teapotlaboratories/bwlc1a/README.md

# blwc1a
 Low-power Cellular GPS Tracker
