teapotlaboratories/bwlc1a/hardware/stack-up.png

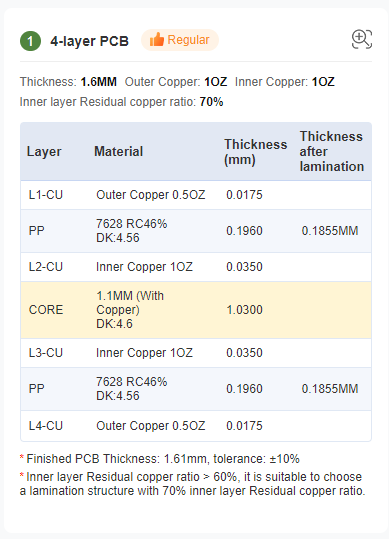
hardware/stack-up.png
