teapotlaboratories/bwlc1a/hardware/kicad/bwlc1a.kicad_pcb

## KiCad design hardware/kicad/bwlc1a.kicad_pcb (2024-05-23)

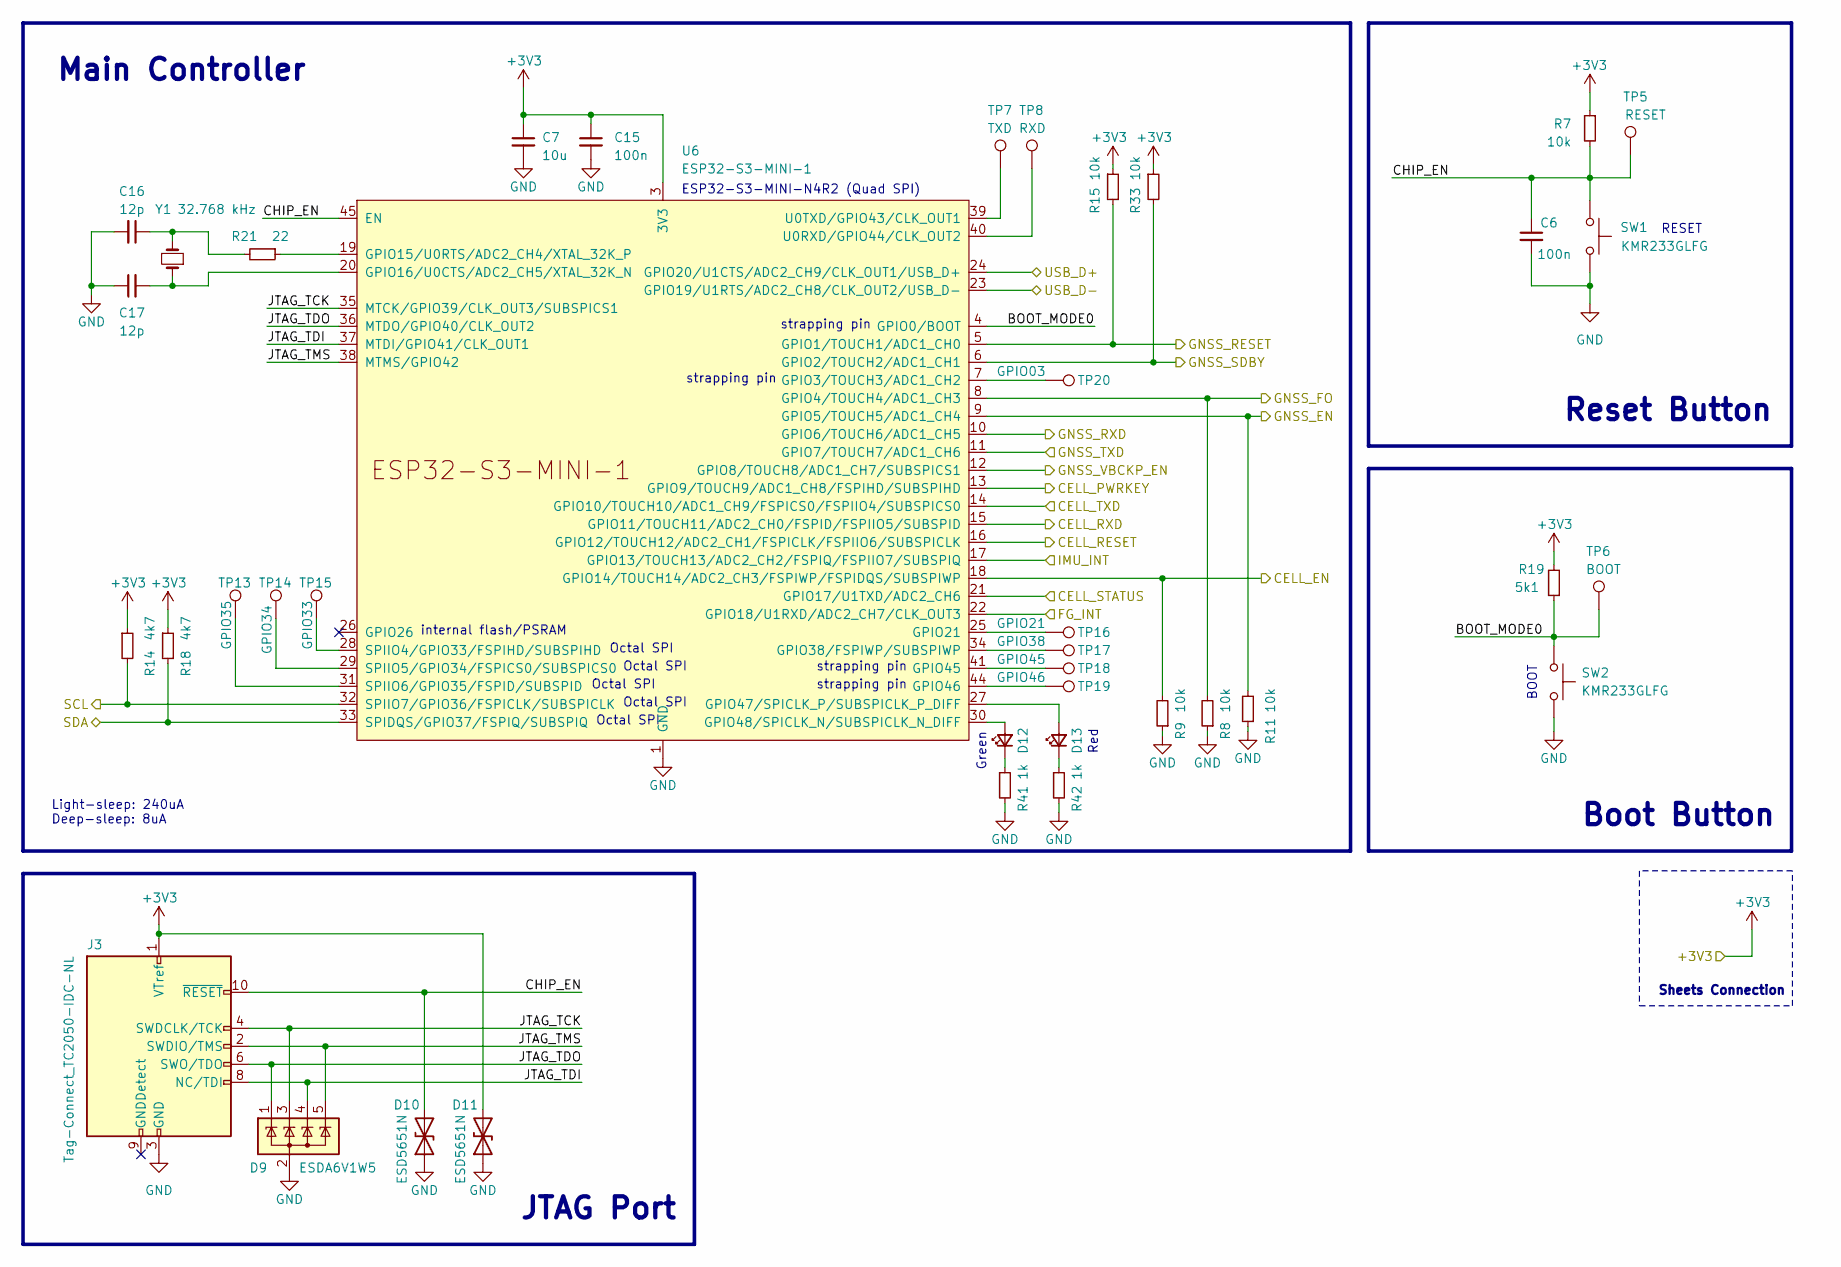
[picture p2: schematic main_controller.kicad_sch, Main Controller]

Parts:
C6, C15: 100n; C_0402_1005Metric; Manufacturer Part Number CL05B104KO5NNNC
C7: 10u; C_0603_1608Metric; Manufacturer Part Number CL10A106KP8NNNC
C16, C17: 12p; C_0402_1005Metric; Manufacturer Part Number 0402CG120J500NT
D9: ESDA6V1W5; SOT-353_SC-70-5; Manufacturer Part Number ESDA6V1W5-TP
D10, D11: ESD5651N; D_SOD-882; Manufacturer Part Number ESD5651N
D12: LTST-C191KGKT; LED_0603_1608Metric; Manufacturer Part Number LTST-C191KGKT
D13: LTST-C191KRKT; LED_0603_1608Metric; Manufacturer Part Number LTST-C191KRKT
J3: Tag-Connect_TC2050-IDC-NL; Tag-Connect_TC2050-IDC-NL_2x05_P1.27mm_Vertical
R7, R8, R9, R11, R15, R33: 10k; R_0402_1005Metric; Manufacturer Part Number 0402WGF1002TCE
R14, R18: 4k7; R_0402_1005Metric; Manufacturer Part Number 0402WGJ0472TCE
R19: 5k1; R_0402_1005Metric; Manufacturer Part Number 0402WGF5101TCE
R21: 22; R_0402_1005Metric; Manufacturer Part Number 0402WGF220JTCE
R41, R42: 1k; R_0402_1005Metric; Manufacturer Part Number 0402WGJ0102TCE
SW1, SW2: KMR233GLFG; SW-SMD_L3.9-W3.0-P4.45; Manufacturer Part Number KMR233GLFG
TP5: RESET; TestPoint_Pad_D1.0mm
TP6: BOOT; TestPoint_Pad_D1.0mm
TP7: TXD; TestPoint_Pad_D1.0mm
TP8: RXD; TestPoint_Pad_D1.0mm
TP13: GPIO35; TestPoint_Pad_D1.0mm
TP14: GPIO34; TestPoint_Pad_D1.0mm
TP15: GPIO33; TestPoint_Pad_D1.0mm
TP16: GPIO21; TestPoint_Pad_D1.0mm
TP17: GPIO38; TestPoint_Pad_D1.0mm
TP18: GPIO45; TestPoint_Pad_D1.0mm
TP19: GPIO46; TestPoint_Pad_D1.0mm
TP20: GPIO03; TestPoint_Pad_D1.0mm
U6: ESP32-S3-MINI-1; Manufacturer Part Number ESP32-S3-MINI-1-N4R2
Y1: 32.768 kHz; Crystal_SMD_3215-2Pin_3.2x1.5mm; Manufacturer Part Number Q13FC1350000400

Connections:
+3V3: C7.1, C15.1, D11.2 (A2), J3.1 (VTref), R7.1, R14.1, R15.1, R18.1, R19.2, R33.1, U6.3 (3V3); also elsewhere on the board
/Cellular/CELL_PWRKEY: U6.13 (GPIO9/TOUCH9/ADC1_CH8/FSPIHD/SUBSPIHD); also elsewhere on the board
/Cellular/CELL_RESET: U6.16 (GPIO12/TOUCH12/ADC2_CH1/FSPICLK/FSPIIO6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); also elsewhere on the board
/Cellular/CELL_RXD: U6.15 (GPIO11/TOUCH11/ADC2_CH0/FSPID/FSPIIO5/S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); also elsewhere on the board
/Cellular/CELL_STATUS: U6.21 (GPIO17/U1TXD/ADC2_CH6); also elsewhere on the board
/Cellular/CELL_TXD: U6.14 (GPIO10/TOUCH10/ADC1_CH9/FSPICS0/FSPIIO4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); also elsewhere on the board
/GNSS/GNSS_FO: R8.2, U6.8 (GPIO4/TOUCH4/ADC1_CH3); also elsewhere on the board
/GNSS/GNSS_RESET: R15.2, U6.5 (GPIO1/TOUCH1/ADC1_CH0); also elsewhere on the board
/GNSS/GNSS_RXD: U6.10 (GPIO6/TOUCH6/ADC1_CH5); also elsewhere on the board
/GNSS/GNSS_SDBY: R33.2, U6.6 (GPIO2/TOUCH2/ADC1_CH1); also elsewhere on the board
/GNSS/GNSS_TXD: U6.11 (GPIO7/TOUCH7/ADC1_CH6); also elsewhere on the board
/Main Controller/BOOT_MODE0: R19.1, SW2.1, TP6.1, U6.4 (GPIO0/BOOT)
/Main Controller/CELL_EN: R9.2, U6.18 (GPIO14/TOUCH14/ADC2_CH3/FSPIWP/FSPIDQS/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); also elsewhere on the board
/Main Controller/CHIP_EN: C6.1, D10.2 (A2), J3.10 (~RESET), R7.2, SW1.2, TP5.1, U6.45 (EN)
/Main Controller/FG_INT: U6.22 (GPIO18/U1RXD/ADC2_CH7/CLK_OUT3); also elsewhere on the board
/Main Controller/GNSS_EN: R11.2, U6.9 (GPIO5/TOUCH5/ADC1_CH4); also elsewhere on the board
/Main Controller/GNSS_VBCKP_EN: U6.12 (GPIO8/TOUCH8/ADC1_CH7/SUBSPICS1); also elsewhere on the board
/Main Controller/IMU_INT: U6.17 (GPIO13/TOUCH13/ADC2_CH2/FSPIQ/FSPIIO7/S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); also elsewhere on the board
/Main Controller/JTAG_TCK: D9.3 (K), J3.4 (SWDCLK/TCK), U6.35 (MTCK/GPIO39/CLK_OUT3/SUBSPICS1)
/Main Controller/JTAG_TDI: D9.4 (K), J3.8 (NC/TDI), U6.37 (MTDI/GPIO41/CLK_OUT1)
/Main Controller/JTAG_TDO: D9.1 (K), J3.6 (SWO/TDO), U6.36 (MTDO/GPIO40/CLK_OUT2)
/Main Controller/JTAG_TMS: D9.5 (K), J3.2 (SWDIO/TMS), U6.38 (MTMS/GPIO42)
/Main Controller/SCL: R14.2, U6.32 (SPIIO7/GPIO36/FSPICLK/SUBSPICLK); also elsewhere on the board
/Main Controller/SDA: R18.2, U6.33 (SPIDQS/GPIO37/FSPIQ/SUBSPIQ); also elsewhere on the board
/Main Controller/USB_D+: U6.24 (GPIO20/U1CTS/ADC2_CH9/CLK_OUT1/USB_D+); also elsewhere on the board
/Main Controller/USB_D-: U6.23 (GPIO19/U1RTS/ADC2_CH8/CLK_OUT2/USB_D-); also elsewhere on the board
GND: C6.2, C7.2, C15.2, C16.2, C17.1, D9.2 (A), D10.1 (A1), D11.1 (A1), J3.3 (GND), J3.5 (GND), R8.1, R9.1, R11.1, R41.2, R42.2, SW1.1, SW2.2, U6.1 (GND), U6.2 (GND), U6.42 (GND), U6.43 (GND), U6.46 (GND), U6.47 (GND), U6.48 (GND), U6.49 (GND), U6.50 (GND), U6.51 (GND), U6.52 (GND), U6.53 (GND), U6.54 (GND), U6.55 (GND), U6.56 (GND), U6.57 (GND), U6.58 (GND), U6.59 (GND), U6.60 (GND), U6.61 (GND), U6.62 (GND), U6.63 (GND), U6.64 (GND), U6.65 (GND); also elsewhere on the board
unnamed: C16.1, R21.2, Y1.2
unnamed: D12.2 (A), U6.30 (GPIO48/SPICLK_N/SUBSPICLK_N_DIFF)
unnamed: D12.1 (K), R41.1
unnamed: D13.2 (A), U6.27 (GPIO47/SPICLK_P/SUBSPICLK_P_DIFF)
unnamed: D13.1 (K), R42.1
unnamed: TP20.1, U6.7 (GPIO3/TOUCH3/ADC1_CH2)
unnamed: R21.1, U6.19 (GPIO15/U0RTS/ADC2_CH4/XTAL_32K_P)
unnamed: C17.2, U6.20 (GPIO16/U0CTS/ADC2_CH5/XTAL_32K_N), Y1.1
unnamed: TP16.1, U6.25 (GPIO21)
unnamed: TP17.1, U6.34 (GPIO38/FSPIWP/SUBSPIWP)
unnamed: TP18.1, U6.41 (GPIO45)
unnamed: TP19.1, U6.44 (GPIO46)
unnamed: TP15.1, U6.28 (SPIIO4/GPIO33/FSPIHD/SUBSPIHD)
unnamed: TP14.1, U6.29 (SPIIO5/GPIO34/FSPICS0/SUBSPICS0)
unnamed: TP13.1, U6.31 (SPIIO6/GPIO35/FSPID/SUBSPID)
unnamed: TP8.1, U6.40 (U0RXD/GPIO44/CLK_OUT2)
unnamed: TP7.1, U6.39 (U0TXD/GPIO43/CLK_OUT1)

Notes on the sheet:
ESP32-S3-MINI-N4R2 (Quad SPI)
Red
Reset Button
strapping pin
Octal SPI
Main Controller
JTAG Port
Green
Boot Button
RESET
Sheets Connection
internal flash/PSRAM
BOOT
Light-sleep: 240uA Deep-sleep: 8uA

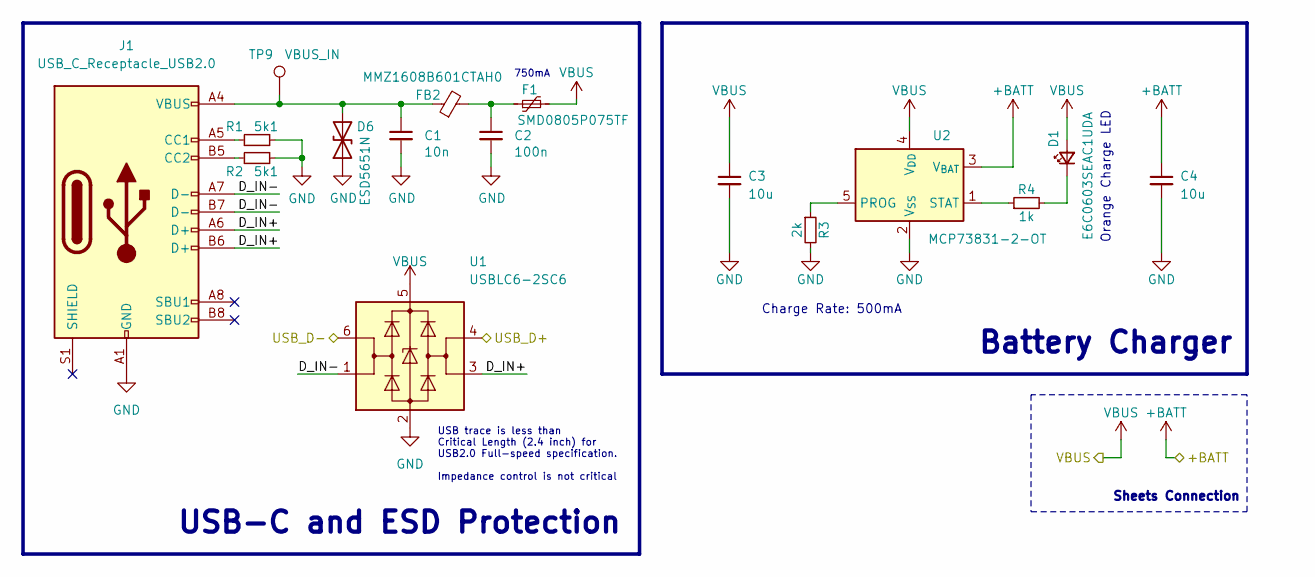
[picture p3: schematic usb_and_charger.kicad_sch, USB and Charger]

Parts:
C1: 10n; C_0402_1005Metric; Manufacturer Part Number CC0402KRX7R9BB103
C2: 100n; C_0402_1005Metric; Manufacturer Part Number CL05B104KO5NNNC
C3, C4: 10u; C_0603_1608Metric; Manufacturer Part Number CL10A106KP8NNNC
D1: E6C0603SEAC1UDA; LED_0603_1608Metric; Manufacturer Part Number E6C0603SEAC1UDA
D6: ESD5651N; D_SOD-882; Manufacturer Part Number ESD5651N
F1: SMD0805P075TF; Fuse_0805_2012Metric; Manufacturer Part Number SMD0805P075TF
FB2: MMZ1608B601CTAH0; L_0603_1608Metric; Manufacturer Part Number MMZ1608B601CTAH0
J1: USB_C_Receptacle_USB2.0; USB_C_Receptacle_HRO_TYPE-C-31-M-12; Manufacturer Part Number TYPE-C-31-M-12
R1, R2: 5k1; R_0402_1005Metric; Manufacturer Part Number 0402WGF5101TCE
R3: 2k; R_0402_1005Metric; Manufacturer Part Number RC0402FR-072KL
R4: 1k; R_0402_1005Metric; Manufacturer Part Number 0402WGJ0102TCE
TP9: VBUS_IN; TestPoint_Pad_D1.0mm
U1: USBLC6-2SC6; SOT-23-6; Manufacturer Part Number USBLC6-2SC6
U2: MCP73831-2-OT; SOT-23-5; Manufacturer Part Number MCP73831T-2ATI/OT

Connections:
+BATT: C4.1, U2.3 (V_{BAT}); also elsewhere on the board
/Main Controller/USB_D+: U1.4 (I/O2); also elsewhere on the board
/Main Controller/USB_D-: U1.6 (I/O1); also elsewhere on the board
/USB and Charger/D_IN+: J1.A6 (D+), J1.B6 (D+), U1.3 (I/O2)
/USB and Charger/D_IN-: J1.A7 (D-), J1.B7 (D-), U1.1 (I/O1)
GND: C1.2, C2.2, C3.2, C4.2, D6.1 (A1), J1.A1 (GND), J1.A12 (GND), J1.B1 (GND), J1.B12 (GND), R1.2, R2.2, R3.2, U1.2 (GND), U2.2 (V_{SS}); also elsewhere on the board
unnamed: C2.1, F1.1, FB2.2
unnamed: D1.1 (K), R4.2
unnamed: C1.1, D6.2 (A2), FB2.1, J1.A4 (VBUS), J1.A9 (VBUS), J1.B4 (VBUS), J1.B9 (VBUS), TP9.1
unnamed: J1.A5 (CC1), R1.1
unnamed: J1.B5 (CC2), R2.1
unnamed: R3.1, U2.5 (PROG)
unnamed: R4.1, U2.1 (STAT)
VBUS: C3.1, D1.2 (A), F1.2, U1.5 (VBUS), U2.4 (V_{DD})

Notes on the sheet:
Orange Charge LED
Battery Charger
USB trace is less than Critical Length (2.4 inch) for USB2.0 Full-speed specification. Impedance control is not critical
Sheets Connection
750mA
Charge Rate: 500mA
USB-C and ESD Protection

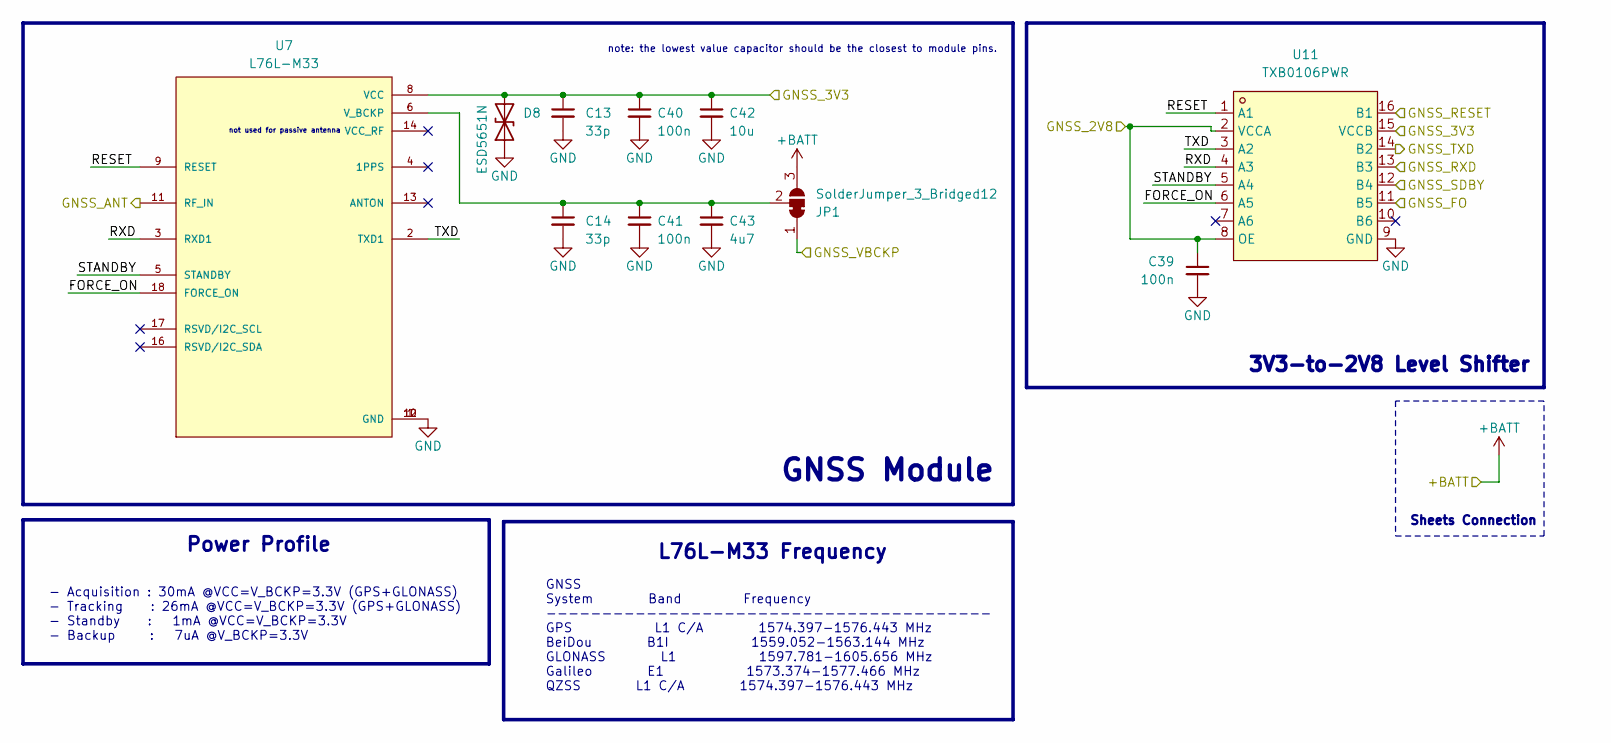
[picture p4: schematic gnss.kicad_sch]

Parts:
C13, C14: 33p; C_0603_1608Metric; Manufacturer Part Number CC0603JRNPO9BN330
C39, C40, C41: 100n; C_0603_1608Metric; Manufacturer Part Number CL10B104KO8NNNC
C42: 10u; C_0603_1608Metric; Manufacturer Part Number CL10A106KP8NNNC
C43: 4u7; C_0603_1608Metric; Manufacturer Part Number CL10A475KP8NNNC
D8: ESD5651N; D_SOD-882; Manufacturer Part Number ESD5651N
JP1: SolderJumper_3_Bridged12; SolderJumper-3_P1.3mm_Bridged2Bar12_RoundedPad1.0x1.5mm
U7: L76L-M33; Manufacturer Part Number L76L-M33
U11: TXB0106PWR; TSSOP-16_L5.0-W4.4-P0.65-LS6.4-BL; Manufacturer Part Number TXB0106PWR

Connections:
+BATT: JP1.3 (B); also elsewhere on the board
/Antenna/GNSS_ANT: U7.11 (RF_IN); also elsewhere on the board
/GNSS/FORCE_ON: U7.18 (FORCE_ON), U11.6 (A5)
/GNSS/GNSS_FO: U11.11 (B5); also elsewhere on the board
/GNSS/GNSS_RESET: U11.16 (B1); also elsewhere on the board
/GNSS/GNSS_RXD: U11.13 (B3); also elsewhere on the board
/GNSS/GNSS_SDBY: U11.12 (B4); also elsewhere on the board
/GNSS/GNSS_TXD: U11.14 (B2); also elsewhere on the board
/GNSS/RESET: U7.9 (RESET), U11.1 (A1)
/GNSS/RXD: U7.3 (RXD1), U11.4 (A3)
/GNSS/STANDBY: U7.5 (STANDBY), U11.5 (A4)
/GNSS/TXD: U7.2 (TXD1), U11.3 (A2)
/GNSS_2V8: C39.1, U11.2 (VCCA), U11.8 (OE); also elsewhere on the board
/GNSS_3V3: C13.1, C40.1, C42.1, D8.2 (A2), U7.8 (VCC), U11.15 (VCCB); also elsewhere on the board
/GNSS_VBCKP: JP1.1 (A); also elsewhere on the board
GND: C13.2, C14.2, C39.2, C40.2, C41.2, C42.2, C43.2, D8.1 (A1), U7.1 (GND), U7.10 (GND), U7.12 (GND), U11.9 (GND); also elsewhere on the board
unnamed: C14.1, C41.1, C43.1, JP1.2 (C), U7.6 (V_BCKP)

Notes on the sheet:
GNSS Module
- Acquisition : 30mA @VCC=V_BCKP=3.3V (GPS+GLONASS) - Tracking : 26mA @VCC=V_BCKP=3.3V (GPS+GLONASS) - Standby : 1mA @VCC=V_BCKP=3.3V - Backup : 7uA @V_BCKP=3.3V
3V3-to-2V8 Level Shifter
not used for passive antenna
Sheets Connection
L76L-M33 Frequency
note: the lowest value capacitor should be the closest to module pins.
GNSS System Band Frequency ---------------------------------------- GPS L1 C/A 1574.397-1576.443 MHz BeiDou B1I 1559.052-1563.144 MHz GLONASS L1 1597.781-1605.656 MHz Galileo E1 1573.374-1577.466 MHz QZSS L1 C/A 1574.397-1576.443 MHz
Power Profile

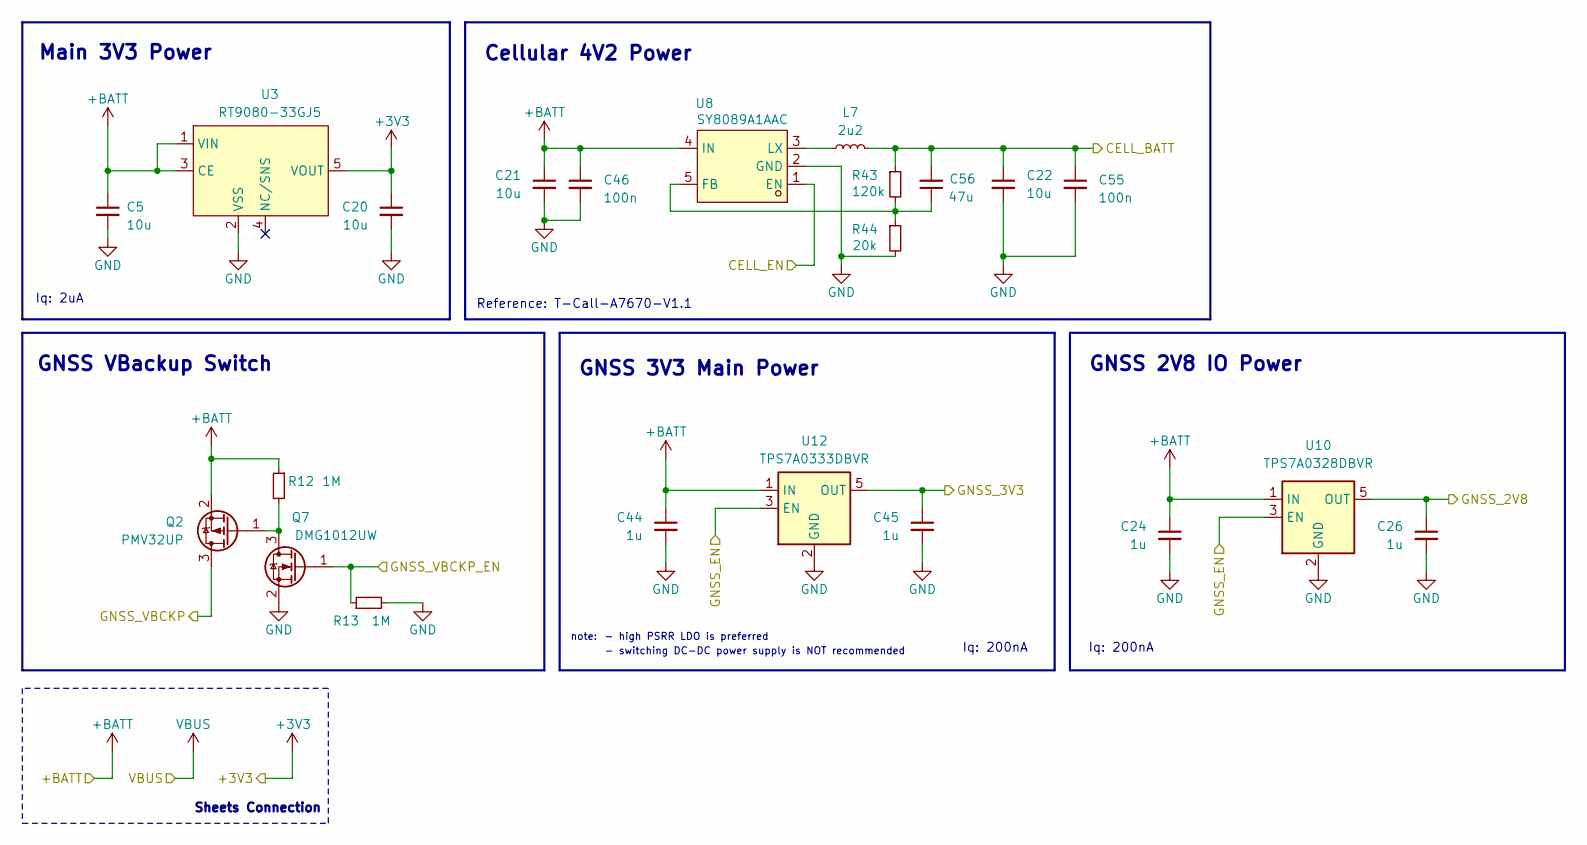
[picture p5: schematic power.kicad_sch]

Parts:
C5, C20, C21, C22: 10u; C_0603_1608Metric; Manufacturer Part Number CL10A106KP8NNNC
C24, C26, C44, C45: 1u; C_0603_1608Metric; Manufacturer Part Number CL10B105KO8NNNC
C46, C55: 100n; C_0603_1608Metric; Manufacturer Part Number CL10B104KO8NNNC
C56: 47u; C_0603_1608Metric; Manufacturer Part Number GRM188R60J476ME15D
L7: 2u2; IND-SMD_L3.0-W3.0_LVS303015H-2R2M-N; Manufacturer Part Number LVS303015-2R2M-N
Q2: PMV32UP; SOT-23; Manufacturer Part Number PMV32UP
Q7: DMG1012UW; SOT-323_SC-70; Manufacturer Part Number DMG1012UW-7
R12, R13: 1M; R_0603_1608Metric; Manufacturer Part Number 0603WAF1004T5E
R43: 120k; R_0603_1608Metric; Manufacturer Part Number 0603WAF1203T5E
R44: 20k; R_0603_1608Metric; Manufacturer Part Number 0603WAF2002T5E
U3: RT9080-33GJ5; SOT-23-5; Manufacturer Part Number RT9080-33GJ5
U8: SY8089A1AAC; SOT-23-5; Manufacturer Part Number SY8089A1AAC
U10: TPS7A0328DBVR; SOT-23-5; Manufacturer Part Number TPS7A0328DBVR
U12: TPS7A0333DBVR; SOT-23-5; Manufacturer Part Number TPS7A0333DBVR

Connections:
+3V3: C20.1, U3.5 (VOUT); also elsewhere on the board
+BATT: C5.1, C21.1, C24.1, C44.1, C46.1, Q2.2 (S), R12.1, U3.1 (VIN), U3.3 (CE), U8.4 (IN), U10.1 (IN), U12.1 (IN); also elsewhere on the board
/Cellular/CELL_BATT: C22.1, C55.1, C56.2, L7.2, R43.1; also elsewhere on the board
/GNSS_2V8: C26.1, U10.5 (OUT); also elsewhere on the board
/GNSS_3V3: C45.1, U12.5 (OUT); also elsewhere on the board
/GNSS_VBCKP: Q2.3 (D); also elsewhere on the board
/Main Controller/CELL_EN: U8.1 (EN); also elsewhere on the board
/Main Controller/GNSS_EN: U10.3 (EN), U12.3 (EN); also elsewhere on the board
/Main Controller/GNSS_VBCKP_EN: Q7.1 (G), R13.1; also elsewhere on the board
GND: C5.2, C20.2, C21.2, C22.2, C24.2, C26.2, C44.2, C45.2, C46.2, C55.2, Q7.2 (S), R13.2, R44.2, U3.2 (VSS), U8.2 (GND), U10.2 (GND), U12.2 (GND); also elsewhere on the board
unnamed: Q2.1 (G), Q7.3 (D), R12.2
unnamed: C56.1, R43.2, R44.1, U8.5 (FB)
unnamed: L7.1, U8.3 (LX)

Notes on the sheet:
Cellular 4V2 Power
- switching DC-DC power supply is NOT recommended
- high PSRR LDO is preferred
GNSS VBackup Switch
Reference: T-Call-A7670-V1.1
GNSS 3V3 Main Power
Iq: 2uA
Main 3V3 Power
Sheets Connection
GNSS 2V8 IO Power
note:
Iq: 200nA

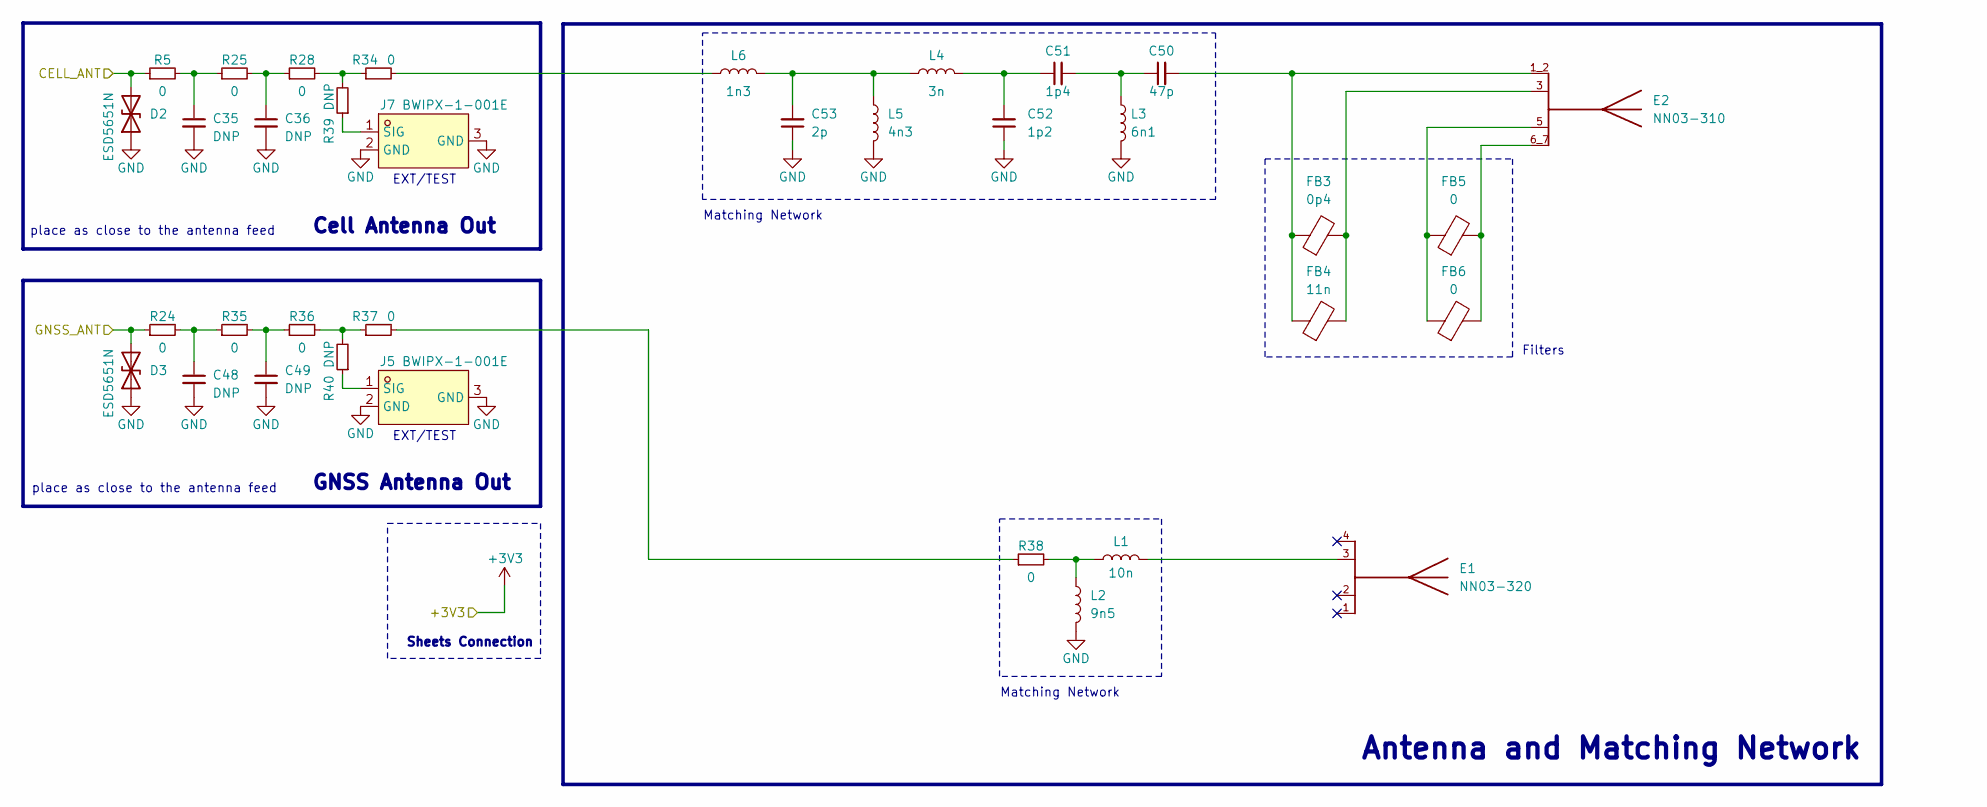
[picture p6: schematic antenna.kicad_sch]

Parts:
C35, C36, C48, C49: DNP; C_0402_1005Metric
C50: 47p; C_0402_1005Metric; Manufacturer Part Number GJM1555C1H470FB01D
C51: 1p4; C_0402_1005Metric; Manufacturer Part Number GJM1555C1H1R4WB01D
C52: 1p2; C_0402_1005Metric; Manufacturer Part Number GJM1555C1H1R2WB01D
C53: 2p; C_0402_1005Metric; Manufacturer Part Number GJM1555C1H2R0WB01D
D2, D3: ESD5651N; D_SOD-882; Manufacturer Part Number ESD5651N
E1: NN03-320; Manufacturer Part Number NN03-320
E2: NN03-310; Manufacturer Part Number NN03-310
FB3: 0p4; L_0402_1005Metric; Manufacturer Part Number GJM1555C1HR40WB01D
FB4: 11n; L_0603_1608Metric; Manufacturer Part Number LQW18AN11NG80D
FB5: 0; L_0402_1005Metric; Manufacturer Part Number 0402WGJ0000TCE
FB6: 0; L_0603_1608Metric; Manufacturer Part Number 0603WAF0000T5E
J5, J7: BWIPX-1-001E; Manufacturer Part Number BWIPX-1-001E
L1: 10n; L_0603_1608Metric; Manufacturer Part Number LQW18AN10NG80
L2: 9n5; L_0603_1608Metric; Manufacturer Part Number LQW18AN9N5G80D
L3: 6n1; L_0402_1005Metric; Manufacturer Part Number LQW15AN6N1B80D
L4: 3n; L_0402_1005Metric; Manufacturer Part Number LQW15AN3N0G80D
L5: 4n3; L_0603_1608Metric; Manufacturer Part Number LQW18AN4N3G80D
L6: 1n3; L_0402_1005Metric; Manufacturer Part Number LQW15AN1N3C80D
R5, R24, R25, R28, R34, R35, R36, R37: 0; R_0402_1005Metric; Manufacturer Part Number 0402WGJ0000TCE
R38: 0; R_0603_1608Metric; Manufacturer Part Number 0603WAF0000T5E
R39, R40: DNP; R_0402_1005Metric

Connections:
/Antenna/CELL_ANT: D2.2 (A2), R5.1; also elsewhere on the board
/Antenna/GNSS_ANT: D3.2 (A2), R24.1; also elsewhere on the board
GND: C35.2, C36.2, C48.2, C49.2, C52.1, C53.1, D2.1 (A1), D3.1 (A1), J5.2 (GND), J5.3 (GND), J7.2 (GND), J7.3 (GND), L2.2, L3.2, L5.2; also elsewhere on the board
unnamed: C35.1, R5.2, R25.1
unnamed: C36.1, R25.2, R28.1
unnamed: C48.1, R24.2, R35.1
unnamed: C49.1, R35.2, R36.1
unnamed: C50.1, C51.2, L3.1
unnamed: C50.2, E2.1_2, FB3.1, FB4.1
unnamed: C51.1, C52.2, L4.2
unnamed: C53.2, L4.1, L5.1, L6.2
unnamed: E1.3, L1.2
unnamed: E2.3, FB3.2, FB4.2
unnamed: E2.5, FB5.1, FB6.1
unnamed: E2.6_7, FB5.2, FB6.2
unnamed: J5.1 (SIG), R40.1
unnamed: J7.1 (SIG), R39.1
unnamed: L1.1, L2.1, R38.2
unnamed: L6.1, R34.2
unnamed: R28.2, R34.1, R39.2
unnamed: R36.2, R37.1, R40.2
unnamed: R37.2, R38.1

Notes on the sheet:
Cell Antenna Out
Filters
EXT/TEST
Sheets Connection
Antenna and Matching Network
place as close to the antenna feed
GNSS Antenna Out
Matching Network

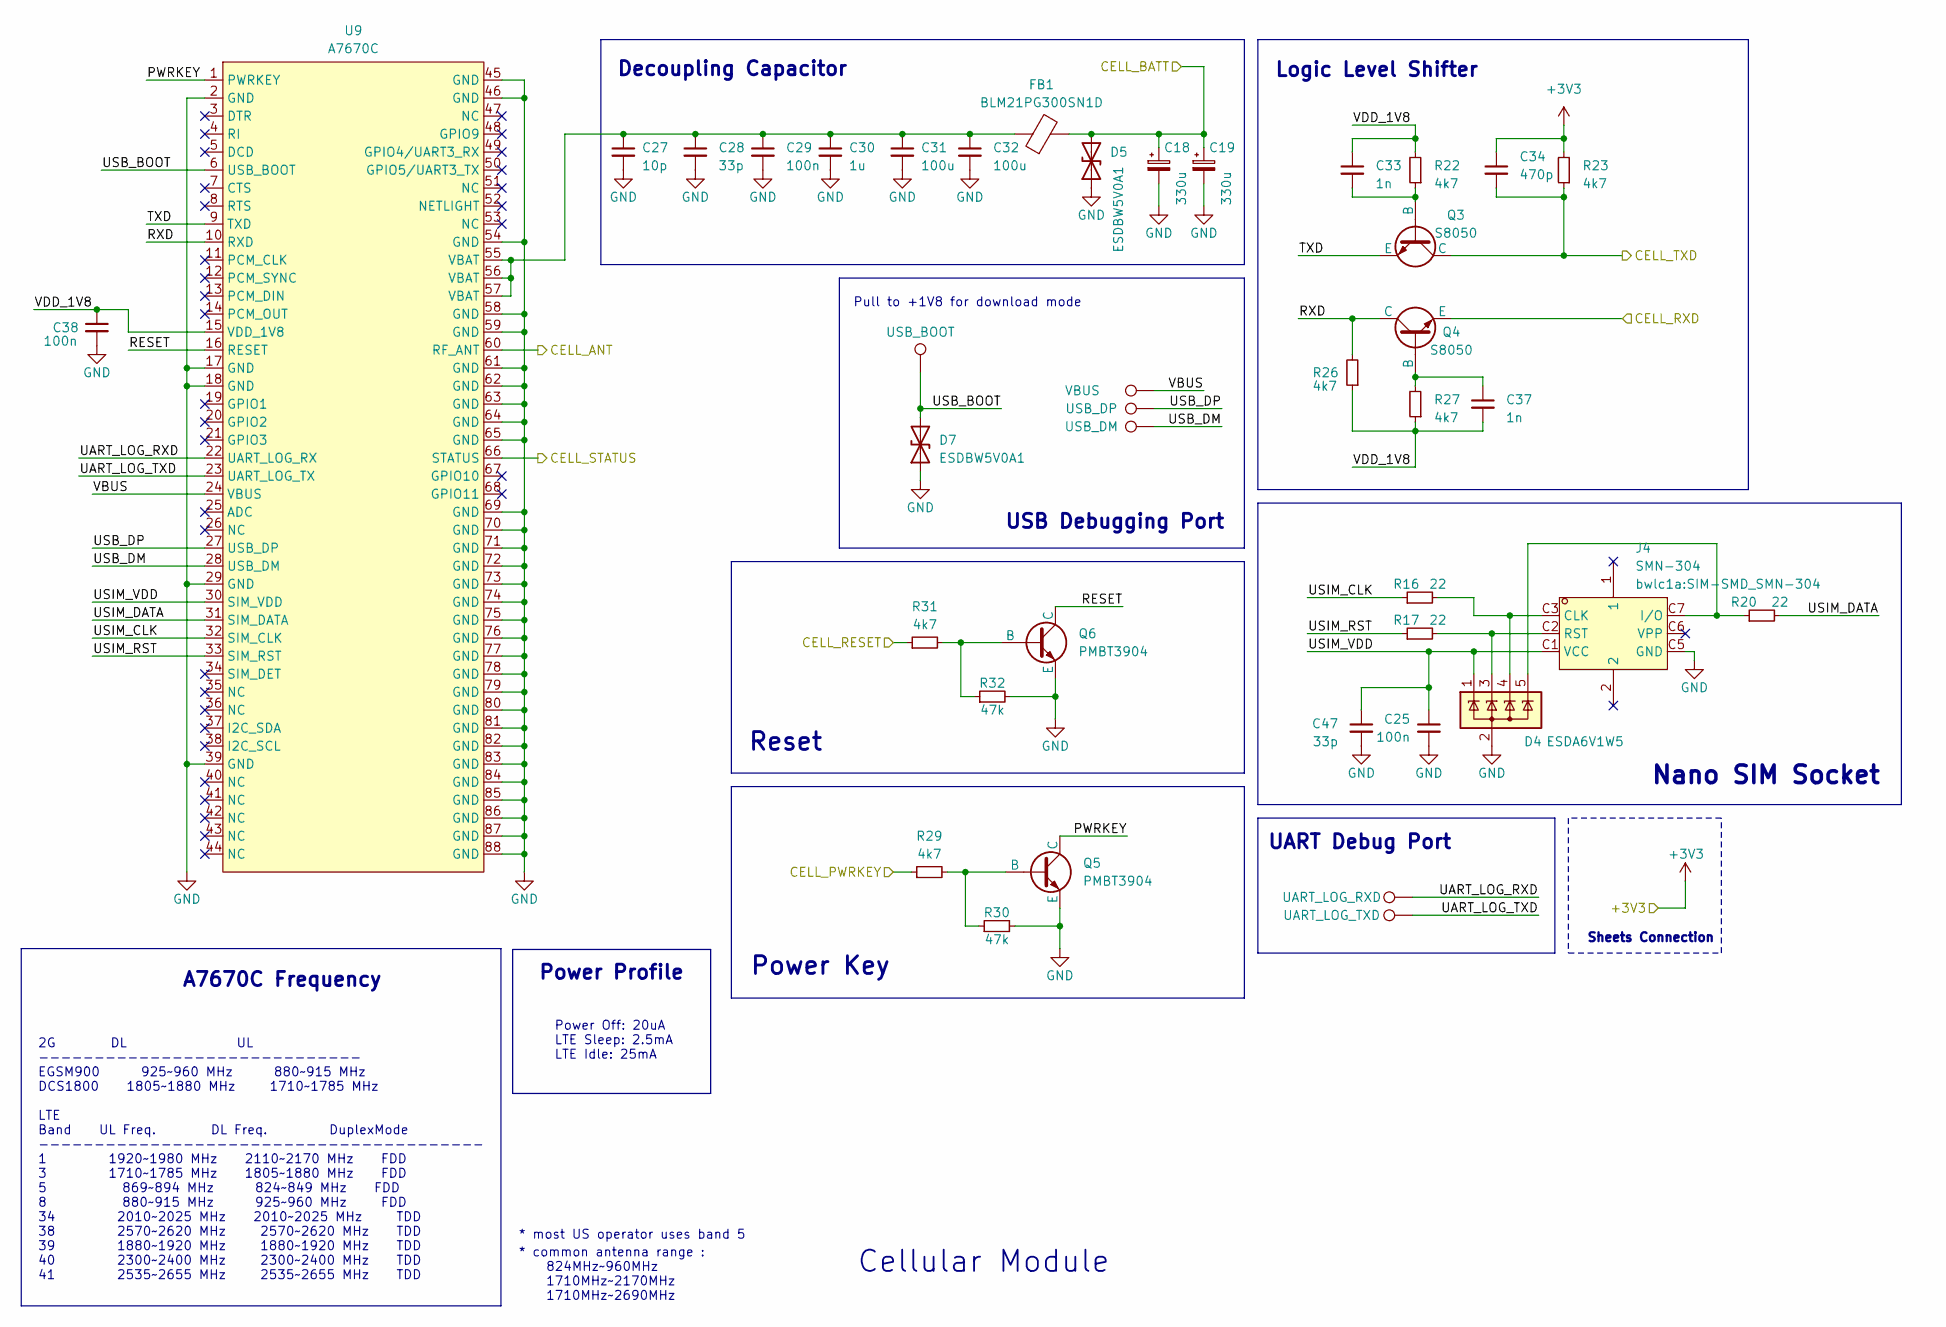
[picture p7: schematic cellular.kicad_sch]

Parts:
C18, C19: 330u; CP_EIA-3528-21_Kemet-B; Manufacturer Part Number T520B337M006ATE040
C25, C29, C38: 100n; C_0402_1005Metric; Manufacturer Part Number CL05B104KO5NNNC
C27: 10p; C_0402_1005Metric; Manufacturer Part Number CC0402JRNPO9BN100
C28, C47: 33p; C_0402_1005Metric; Manufacturer Part Number 0402CG330J500NT
C30: 1u; C_0402_1005Metric; Manufacturer Part Number CL05A105KP5NNNC
C31, C32: 100u; C_0805_2012Metric; Manufacturer Part Number GRM21BR60J107ME15L
C33, C37: 1n; C_0402_1005Metric; Manufacturer Part Number CL05B102KB5NNNC
C34: 470p; C_0402_1005Metric; Manufacturer Part Number CC0402KRX7R9BB471
D4: ESDA6V1W5; SOT-353_SC-70-5; Manufacturer Part Number ESDA6V1W5-TP
D5, D7: ESDBW5V0A1; D_SOD-882; Manufacturer Part Number ESDBW5V0A1
FB1: BLM21PG300SN1D; L_0805_2012Metric; Manufacturer Part Number BLM21PG300SN1D
J4: SMN-304; SIM-SMD_SMN-304; Manufacturer Part Number SMN-304
Q3, Q4: S8050; SOT-23; Manufacturer Part Number S8050
Q5, Q6: PMBT3904; SOT-23; Manufacturer Part Number S8050
R16, R17, R20: 22; R_0402_1005Metric; Manufacturer Part Number 0402WGF220JTCE
R22, R23, R26, R27, R29, R31: 4k7; R_0402_1005Metric; Manufacturer Part Number 0402WGJ0472TCE
R30, R32: 47k; R_0402_1005Metric; Manufacturer Part Number 0402WGF4702TCE
TP1: USB_DP; TestPoint_Pad_D1.0mm
TP2: USB_DM; TestPoint_Pad_D1.0mm
TP3: VBUS; TestPoint_Pad_D1.0mm
TP4: UART_LOG_RXD; TestPoint_Pad_D1.0mm
TP11: USB_BOOT; TestPoint_Pad_D1.0mm
TP12: UART_LOG_TXD; TestPoint_Pad_D1.0mm
U9: A7670C; LGA-124_L24.0-W24.0-P1.0-A7670C-LASS; Manufacturer Part Number A7670C-MASL

Connections:
+3V3: C34.1, R23.2; also elsewhere on the board
/Antenna/CELL_ANT: U9.60 (RF_ANT); also elsewhere on the board
/Cellular/CELL_BATT: C18.1, C19.1, D5.2 (A2), FB1.2; also elsewhere on the board
/Cellular/CELL_PWRKEY: R29.1; also elsewhere on the board
/Cellular/CELL_RESET: R31.1; also elsewhere on the board
/Cellular/CELL_RXD: Q4.3 (E); also elsewhere on the board
/Cellular/CELL_STATUS: U9.66 (STATUS); also elsewhere on the board
/Cellular/CELL_TXD: C34.2, Q3.1 (C), R23.1; also elsewhere on the board
/Cellular/PWRKEY: Q5.1 (C), U9.1 (PWRKEY)
/Cellular/RESET: Q6.1 (C), U9.16 (RESET)
/Cellular/RXD: Q4.1 (C), R26.2, U9.10 (RXD)
/Cellular/TXD: Q3.3 (E), U9.9 (TXD)
/Cellular/UART_LOG_RXD: TP4.1, U9.22 (UART_LOG_RX)
/Cellular/UART_LOG_TXD: TP12.1, U9.23 (UART_LOG_TX)
/Cellular/USB_BOOT: D7.2 (A2), TP11.1, U9.6 (USB_BOOT)
/Cellular/USB_DM: TP2.1, U9.28 (USB_DM)
/Cellular/USB_DP: TP1.1, U9.27 (USB_DP)
/Cellular/USIM_CLK: R16.1, U9.32 (SIM_CLK)
/Cellular/USIM_DATA: R20.2, U9.31 (SIM_DATA)
/Cellular/USIM_RST: R17.1, U9.33 (SIM_RST)
/Cellular/USIM_VDD: C25.1, C47.1, D4.1 (K), J4.C1 (VCC), U9.30 (SIM_VDD)
/Cellular/VBUS: TP3.1, U9.24 (VBUS)
/Cellular/VDD_1V8: C33.1, C37.2, C38.1, R22.2, R26.1, R27.1, U9.15 (VDD_1V8)
GND: C18.2, C19.2, C25.2, C27.2, C28.2, C29.2, C30.2, C31.2, C32.2, C38.2, C47.2, D4.2 (A), D5.1 (A1), D7.1 (A1), J4.C5 (GND), Q5.3 (E), Q6.3 (E), R30.2, R32.2, U9.2 (GND), U9.17 (GND), U9.18 (GND), U9.29 (GND), U9.39 (GND), U9.45 (GND), U9.46 (GND), U9.54 (GND), U9.58 (GND), U9.59 (GND), U9.61 (GND), U9.62 (GND), U9.63 (GND), U9.64 (GND), U9.65 (GND), U9.69 (GND), U9.70 (GND), U9.71 (GND), U9.72 (GND), U9.73 (GND), U9.74 (GND), U9.75 (GND), U9.76 (GND), U9.77 (GND), U9.78 (GND), U9.79 (GND), U9.80 (GND), U9.81 (GND), U9.82 (GND), U9.83 (GND), U9.84 (GND), U9.85 (GND), U9.86 (GND), U9.87 (GND), U9.88 (GND); also elsewhere on the board
unnamed: C27.1, C28.1, C29.1, C30.1, C31.1, C32.1, FB1.1, U9.55 (VBAT), U9.56 (VBAT), U9.57 (VBAT)
unnamed: D4.4 (K), J4.C3 (CLK), R16.2
unnamed: D4.5 (K), J4.C7 (I/O), R20.1
unnamed: D4.3 (K), J4.C2 (RST), R17.2
unnamed: C33.2, Q3.2 (B), R22.1
unnamed: C37.1, Q4.2 (B), R27.2
unnamed: Q5.2 (B), R29.2, R30.1
unnamed: Q6.2 (B), R31.2, R32.1

Notes on the sheet:
Decoupling Capacitor
Pull to +1V8 for download mode
Power Key
Nano SIM Socket
Reset
Power Off: 20uA LTE Sleep: 2.5mA LTE Idle: 25mA
Logic Level Shifter
Sheets Connection
A7670C Frequency
UART Debug Port
2G DL UL ----------------------------- EGSM900 925~960 MHz 880~915 MHz DCS1800 1805~1880 MHz 1710~1785 MHz LTE Band UL Freq. DL Freq. DuplexMode ---------------------------------------- 1 1920~1980 MHz 2110~2170 MHz FDD 3 1710~1785 MHz 1805~1880 MHz FDD 5 869~894 MHz 824~849 MHz FDD 8 880~915 MHz 9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
* most US operator uses band 5
USB Debugging Port
* common antenna range : 824MHz~960MHz 1710MHz~2170MHz 1710MHz~2690MHz
Power Profile
Cellular Module

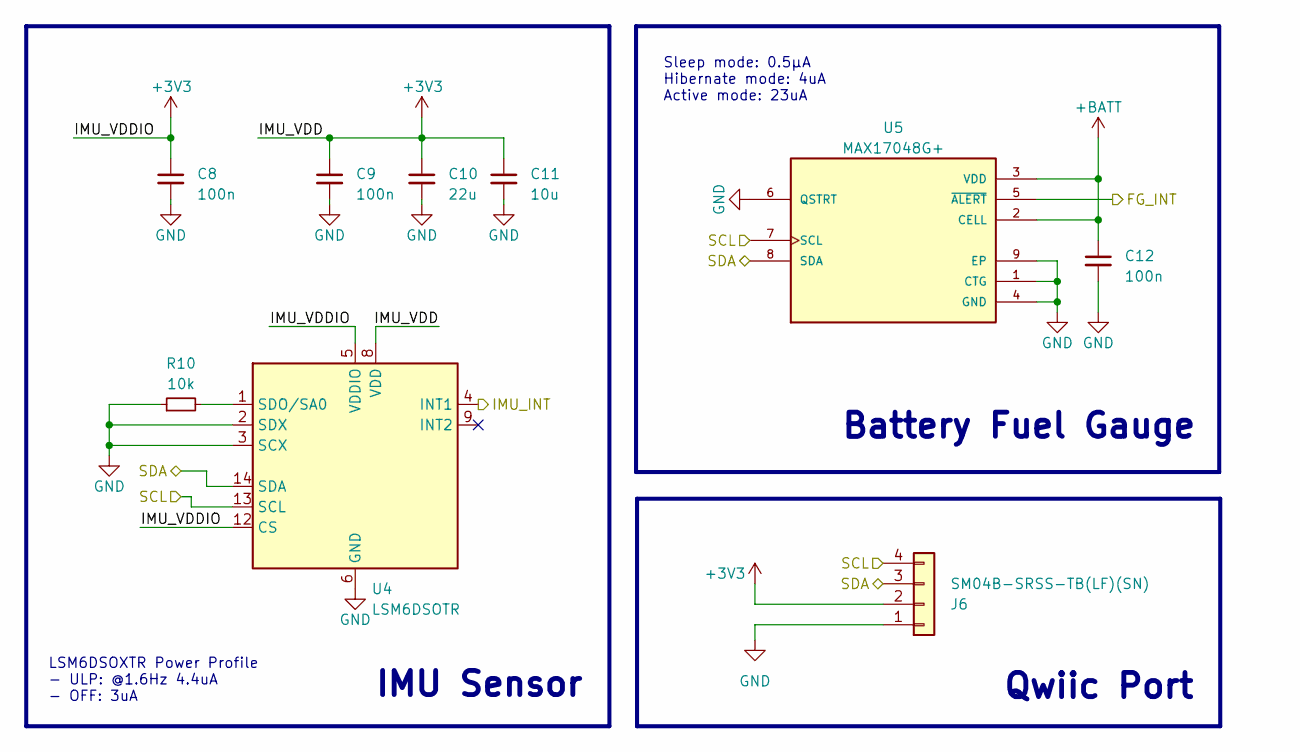
[picture p8: schematic sensors.kicad_sch]

Parts:
C8, C9, C12: 100n; C_0402_1005Metric; Manufacturer Part Number CL05B104KO5NNNC
C10: 22u; C_0603_1608Metric; Manufacturer Part Number CL10A226MP8NUNE
C11: 10u; C_0603_1608Metric; Manufacturer Part Number CL10A106KP8NNNC
J6: SM04B-SRSS-TB(LF)(SN); JST_SH_SM04B-SRSS-TB_1x04-1MP_P1.00mm_Horizontal; Manufacturer Part Number SM04B-SRSS-TB(LF)(SN)
R10: 10k; R_0402_1005Metric; Manufacturer Part Number 0402WGF1002TCE
U4: LSM6DSOTR; LGA-14_3x2.5mm_P0.5mm_LayoutBorder3x4y; Manufacturer Part Number LSM6DSOTR
U5: MAX17048G+; DFN-8-1EP_2x2mm_P0.5mm_EP0.7x1.3mm; Manufacturer Part Number MAX17048G+T10

Connections:
+3V3: C8.1, C9.1, C10.1, C11.1, J6.2, U4.5 (VDDIO), U4.8 (VDD), U4.12 (CS); also elsewhere on the board
+BATT: C12.1, U5.2 (CELL), U5.3 (VDD); also elsewhere on the board
/Main Controller/FG_INT: U5.5 (~ALERT); also elsewhere on the board
/Main Controller/IMU_INT: U4.4 (INT1); also elsewhere on the board
/Main Controller/SCL: J6.4, U4.13 (SCL), U5.7 (SCL); also elsewhere on the board
/Main Controller/SDA: J6.3, U4.14 (SDA), U5.8 (SDA); also elsewhere on the board
GND: C8.2, C9.2, C10.2, C11.2, C12.2, J6.1, R10.1, U4.2 (SDX), U4.3 (SCX), U4.6 (GND), U4.7 (GND), U5.1 (CTG), U5.4 (GND), U5.6 (QSTRT), U5.9 (EP); also elsewhere on the board
unnamed: R10.2, U4.1 (SDO/SA0)

Notes on the sheet:
IMU Sensor
LSM6DSOXTR Power Profile - ULP: @1.6Hz 4.4uA - OFF: 3uA
Battery Fuel Gauge
Qwiic Port
Sleep mode: 0.5µA Hibernate mode: 4uA Active mode: 23uA
