teapotlaboratories/bwlc1a/hardware/kicad/bwlc1a.kicad_pcb

## KiCad design hardware/kicad/bwlc1a.kicad_pcb (continued)

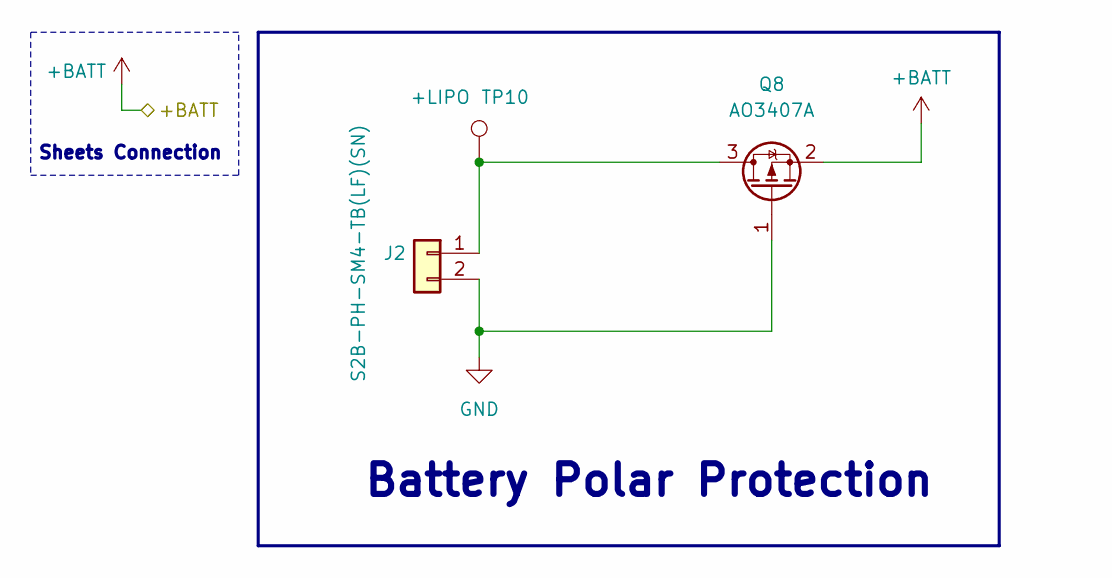
[picture p9: schematic battery.kicad_sch]

Parts:
J2: S2B-PH-SM4-TB(LF)(SN); JST_PH_S2B-PH-SM4-TB_1x02-1MP_P2.00mm_Horizontal; Manufacturer Part Number S2B-PH-SM4-TB(LF)(SN)
Q8: AO3407A; SOT-23; Part Description MOSFET P Channel 30V 4.3A 48mΩ@10V,4.3A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
TP10: +LIPO; TestPoint_Pad_D1.0mm

Connections:
+BATT: Q8.2 (S); also elsewhere on the board
GND: J2.2, Q8.1 (G); also elsewhere on the board
unnamed: J2.1, Q8.3 (D), TP10.1

Notes on the sheet:
Battery Polar Protection
Sheets Connection

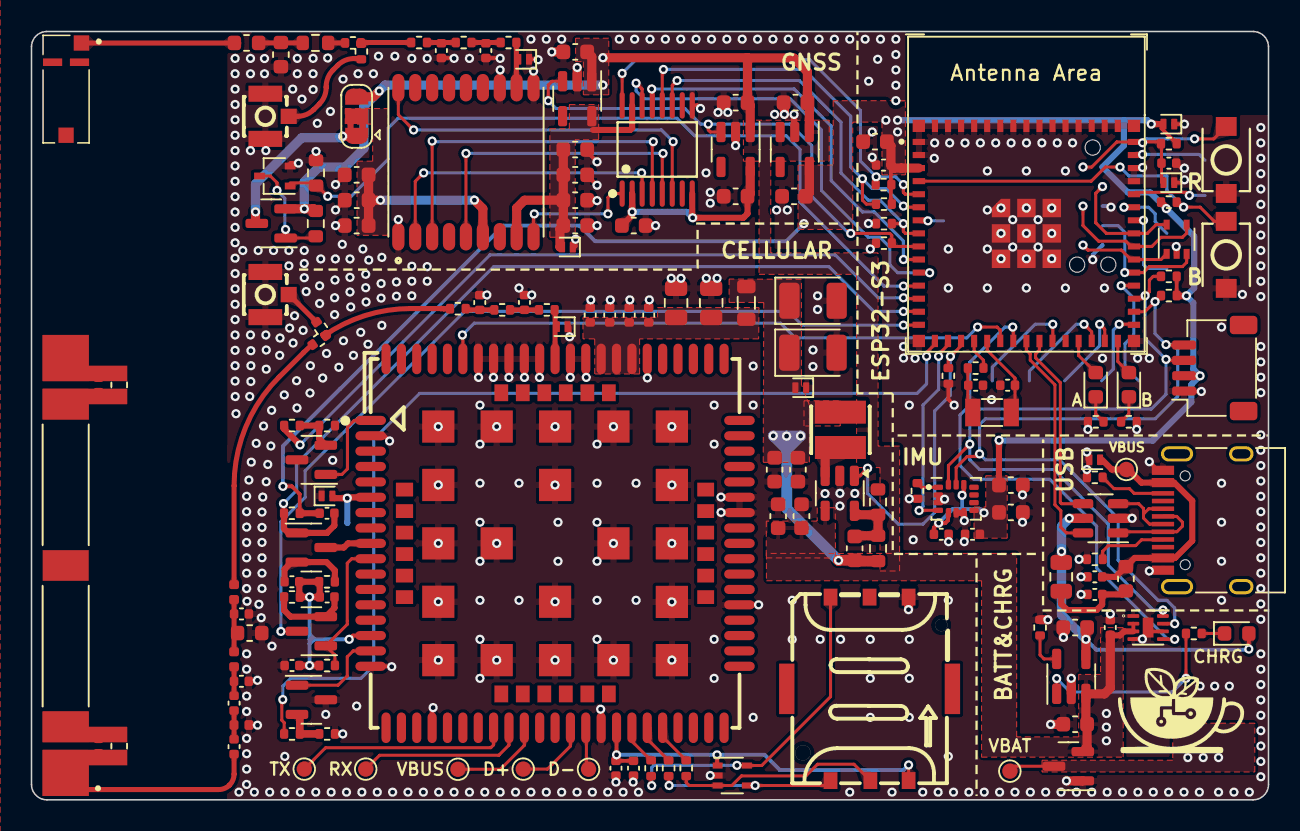
[picture p10: board bwlc1a.kicad_pcb from above]

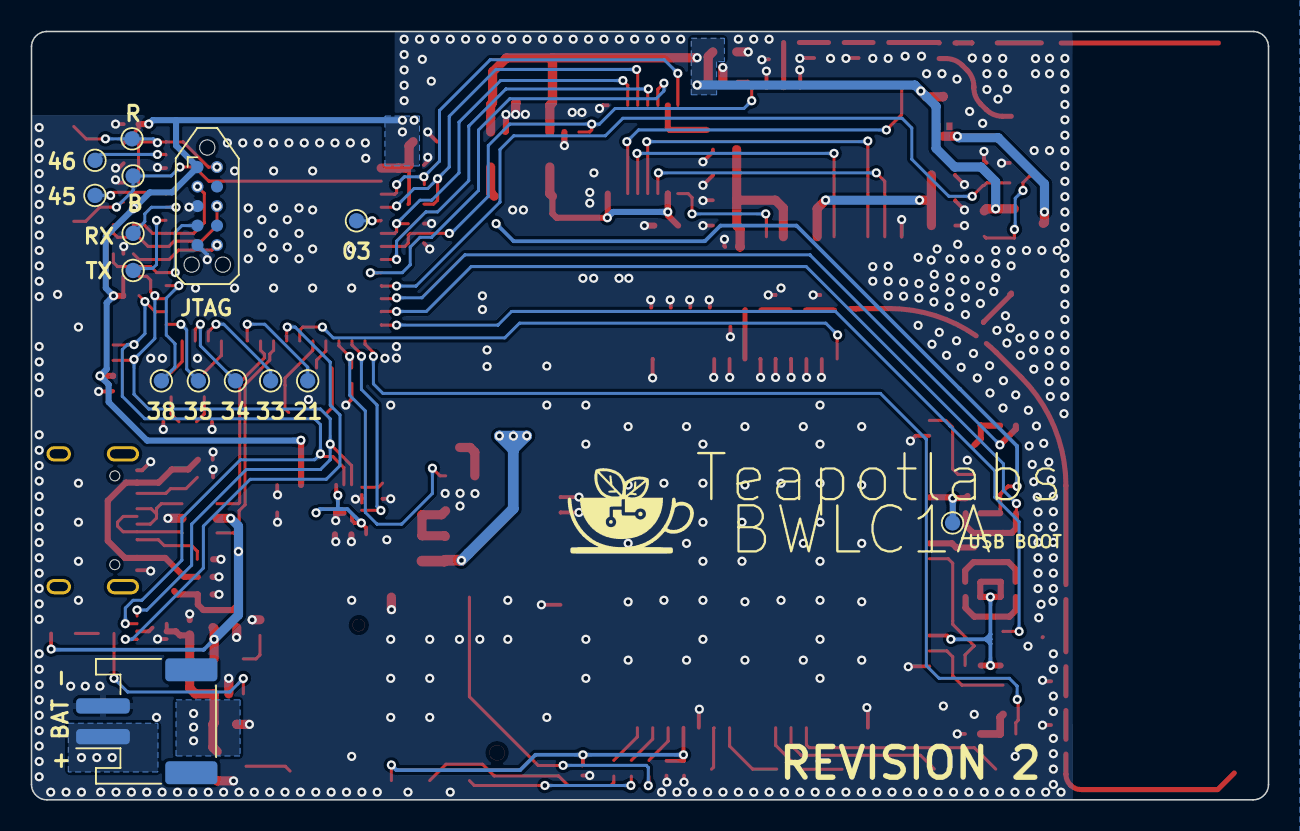
[picture p11: board bwlc1a.kicad_pcb from below]

Board: 4 copper layers, 80.5 x 50.0 mm, 176 parts (15 on the bottom side), 114 nets.
