teapotlaboratories/bwlc1a/(commit log)

2023-05-31 Innitial commit - Kicad project
    [bwlc1a.kicad_pcb, bwlc1a.kicad_sch]
2023-06-07 Update Library
    [ANT-915-USP410.step, BME680.step, BMI088.step, BMM150.step, CON-SMA-EDGE-S--3DModel-STEP-269445.STEP, Coilcraft-LPS4012.step, DC-001-A-2.1mm-R.STEP, FH12-22S-0.5SH.stp]
2023-07-25 Push before change to ESP32 S3
    [L86-M33.step, MAX17048G_.step, bwlc1a.kicad_pcb, bwlc1a.kicad_sch, bwlc1a_A7670C.kicad_sch]
2023-07-29 Finish Sch, start Layouting
    [RSP-122811-02.step, SIM8051-6-0-14-00-X-REVD.step, TPS62290DRVR.step, bwlc1a.kicad_pcb, bwlc1a.kicad_sch, bwlc1a_A7670C.kicad_sch]
2023-08-10 Update on PCB Layout
    [bwlc1a.kicad_pcb, bwlc1a_A7670C.kicad_sch]
2023-08-19 Update on routing
    [bwlc1a.kicad_pcb, bwlc1a.kicad_sch, bwlc1a_A7670C.kicad_sch]
2023-09-14 PCB Layout update + Silkscreen
    [bwlc1a.kicad_pcb, bwlc1a.kicad_sch, bwlc1a_A7670C.kicad_sch]
2023-10-03 Update PCB
    [bwlc1a.kicad_pcb, bwlc1a.kicad_sch, bwlc1a_A7670C.kicad_sch]
2023-10-03 Added production file
    [bwlc1a.csv, positions.csv]
2023-10-13 Update A7670C footprint
    [bwlc1a.kicad_pcb, bwlc1a_A7670C.kicad_sch]
2023-10-13 Update BOM and POS
    [bwlc1a.csv, bwlc1a.kicad_pcb, bwlc1a_BOM.xlsx, positions.csv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]
2023-10-14 Production file update
    [bwlc1a-bom.xlsx, bwlc1a.kicad_pcb, bwlc1a_BOM.xlsx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]
2023-10-21 Production files updates
    [bwlc1a-pos.xlsx]
2023-10-27 update design
    [bwlc1a.kicad_pcb, bwlc1a.kicad_sch, bwlc1a_A7670C.kicad_sch]
2023-10-28 wip: revision 2
    [a7670.kicad_sch, bwlc1a.kicad_sch]
2023-10-29 breakdown sheets
    [bwlc1a.kicad_sch, gnss.kicad_sch]
2023-10-29 breaksdown schematic
    [battery.kicad_sch, bwlc1a.kicad_sch, cellular.kicad_sch, gnss.kicad_sch, main_controller.kicad_sch, power.kicad_sch, sensors.kicad_sch, usb_and_charger.kicad_sch]
2023-10-31 update antenna
    [antenna.kicad_sch]
2023-11-02 update antenna info
    [antenna.kicad_sch]
2023-11-02 add freq info
    [antenna.kicad_sch]
2023-11-03 update freq
    [antenna.kicad_sch]
2023-11-04 add te antenna
2023-11-05 update antenna design
    [antenna.kicad_sch]
2023-11-06 update antenna schematic
    [antenna.kicad_sch]
2023-11-06 add test point for on-board antenna
    [antenna.kicad_sch]
2023-11-07 add ufl connector
2023-11-07 remove antenna switch
    [antenna.kicad_sch]
2023-11-07 add te connectivity antenna schematicY
    [antenna.kicad_sch]
2023-11-07 add todo comment
    [antenna.kicad_sch]
2023-11-07 add matching network close to antenna feed
    [antenna.kicad_sch]
2023-11-08 clean-up and update antenna
    [antenna.kicad_sch, main_controller.kicad_sch, power.kicad_sch, sensors.kicad_sch]
2023-11-25 ignion antenna design
    [antenna.kicad_sch, power.kicad_sch]
2023-12-16 Added Ignion Antenna
    [antenna.kicad_sch, cellular.kicad_sch, gnss.kicad_sch, power.kicad_sch]
2024-01-13 Early PCB Layouting
    [antenna.kicad_sch, bwlc1a.kicad_pcb, sensors.kicad_sch]
2024-02-28 PCB Layout Update
    [antenna.kicad_sch, bwlc1a.kicad_pcb, main_controller.kicad_sch, power.kicad_sch, usb_and_charger.kicad_sch]
2024-03-05 update to KiCAD 8 and add cell power regulator
    [antenna.kicad_sch, battery.kicad_sch, bwlc1a.kicad_pcb, bwlc1a.kicad_sch, cellular.kicad_sch, gnss.kicad_sch, main_controller.kicad_sch, power.kicad_sch]
2024-03-05 add marker for blender export
    [bwlc1a.kicad_pcb]
2024-03-06 remove unused footprints and models
2024-03-06 import footprints and models to bwlc1a
2024-03-06 move components to use bwlc1a library
    [bwlc1a.kicad_pcb, cellular.kicad_sch, main_controller.kicad_sch, sensors.kicad_sch, usb_and_charger.kicad_sch]
2024-03-06 GNSS power uses cheaper LDO
    [power.kicad_sch]
2024-03-06 Revert "GNSS power uses cheaper LDO"
    This reverts commit 0e9862c17de09eba40dda24cbaa62e3753723199.
    [power.kicad_sch]
2024-03-08 library clean-up
    [ANT-915-USP410.step, BME680.step, BMI088.step, BMM150.step, CON-SMA-EDGE-S--3DModel-STEP-269445.STEP, Coilcraft-LPS4012.step, DC-001-A-2.1mm-R.STEP, FH12-22S-0.5SH.stp]
2024-03-08 no changes
    [bwlc1a.kicad_pcb]
2024-03-08 change teapotlabs logo library
    [bwlc1a.kicad_pcb]
2024-03-15 finalizing usb and charger bom
    [usb_and_charger.kicad_sch]
2024-04-29 add jst for battery
2024-04-29 update schematics bom
    [antenna.kicad_sch, battery.kicad_sch, bwlc1a.kicad_pcb, bwlc1a.kicad_sch, cellular.kicad_sch, gnss.kicad_sch, main_controller.kicad_sch, power.kicad_sch]
2024-04-29 uppdate bill of materials
    [battery.kicad_sch]
2024-04-29 update bill of materials
    [battery.kicad_sch]
2024-05-18 add page info
    [antenna.kicad_sch, battery.kicad_sch, bwlc1a.kicad_sch, cellular.kicad_sch, gnss.kicad_sch, main_controller.kicad_sch, power.kicad_sch, sensors.kicad_sch]
2024-05-18 fix antenna impedance
    [bwlc1a.kicad_pcb]
2024-05-18 combine resistor antenna feed pin for gnss and cell
    [bwlc1a.kicad_pcb]
2024-05-18 minor silkscreen edit
    [bwlc1a.kicad_pcb]
2024-05-21 add gnd stitching
    [bwlc1a.kicad_pcb]
2024-05-21 add logo
    [bwlc1a.kicad_pcb]
2024-05-21 first pass of drc
    [bwlc1a.kicad_pcb]
2024-05-22 fix drc errors and warnings
    [bwlc1a.kicad_pcb]
2024-05-22 fix layout
    [bwlc1a.kicad_pcb]
2024-05-23 fix drc, layout and schematics
    [antenna.kicad_sch, battery.kicad_sch, bwlc1a.kicad_pcb, bwlc1a.kicad_sch, cellular.kicad_sch, gnss.kicad_sch, main_controller.kicad_sch, power.kicad_sch]
2024-05-23 finalizing board info
    [antenna.kicad_sch, bwlc1a.kicad_pcb]
2024-05-23 add pin indicator for fuel gauge
    [bwlc1a.kicad_pcb]
2024-05-23 add manufacturing files
    [TeapotlabsBWCL1A_BOM.csv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]
2024-05-23 remove old manufacturing files
    [bwlc1a-bom.xlsx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]
2024-05-23 ad blender markings
    [bwlc1a.kicad_pcb]
2024-06-18 fix incorrect bill of material
    [TeapotlabsBWCL1A_BOM.csv, main_controller.kicad_sch]
